DanielHeEGG/RFPhoenix-Hardware/README.md

# RF Phoenix
Open source wireless igniter for amateur rocketry
