DanielHeEGG/RFPhoenix-Hardware/Fabrication/RFPhoenix-Transmitter.FCStd

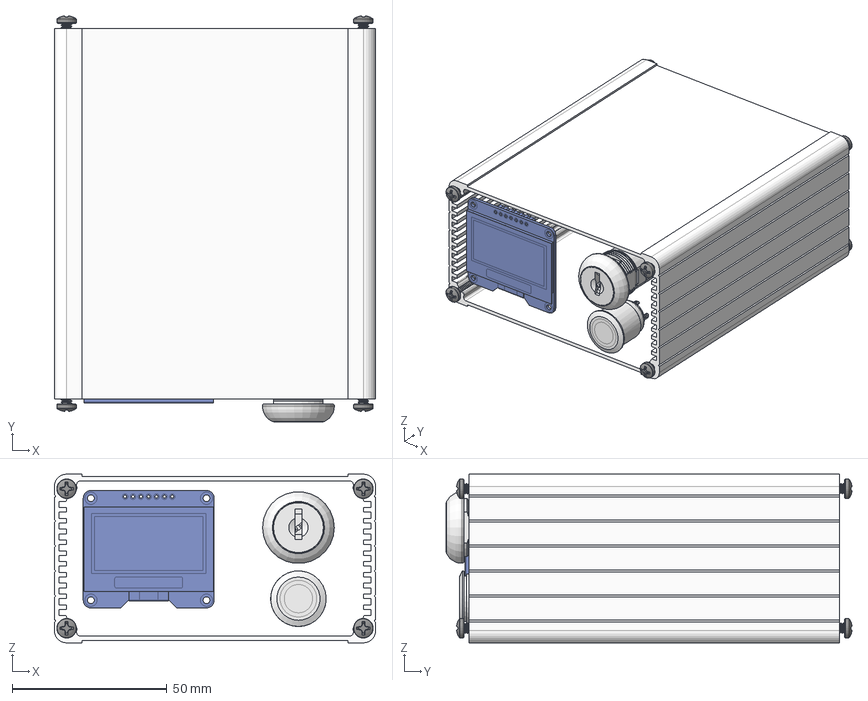
[picture p1: CAD file, 2023-04-13]
Fabrication/RFPhoenix-Transmitter.FCStd
104.0 x 131.4 x 54.6 mm
120mm N Extrusion
6-32 PH x .5 Screw
6-32 PH x .5 Screw001
6-32 PH x .5 Screw002
6-32 PH x .5 Screw003
6-32 PH x .5 Screw004
6-32 PH x .5 Screw005
6-32 PH x .5 Screw006
6-32 PH x .5 Screw007
Orient Display AOM12864A0-2.54
Y201132C203NQ_PART2
Y201132C203NQ_PART1
E-Switch PV6F240SS-341
