DanielHeEGG/RFPhoenix-Hardware/FrontPanel/RFP-Front.kicad_pcb

## KiCad design FrontPanel/RFP-Front.kicad_pcb (2023-05-20)

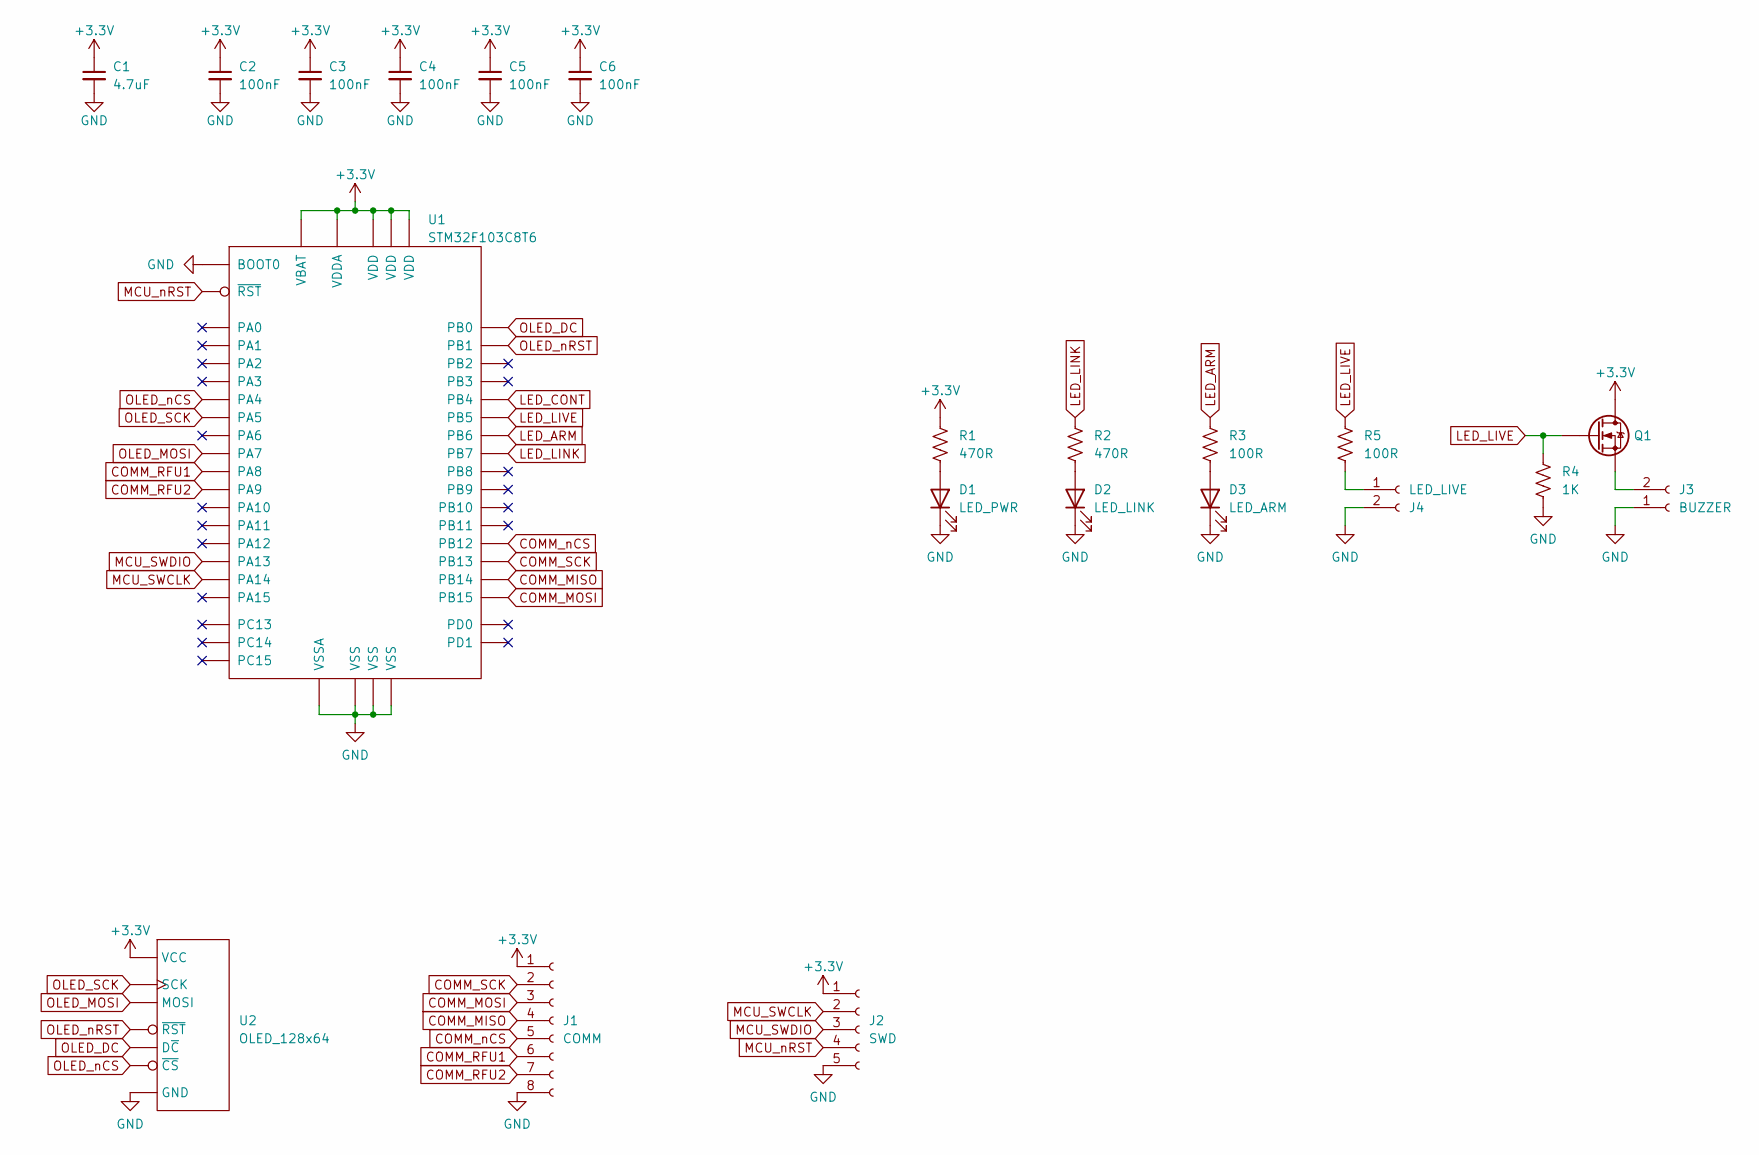
[picture p2: schematic RFP-Front.kicad_sch]

Parts:
C1: 4.7uF; C_0603_1608Metric; Part# Generic 4.7uF 6.3V 0603 X7R MLCC
C2, C3, C4, C5, C6: 100nF; C_0402_1005Metric; Part# Generic 100nF 6.3V 0402 X7R MLCC
D1: LED_PWR; LED_0603_1608Metric; Part# Generic Red 0603 LED
D2: LED_LINK; LED_0603_1608Metric; Part# Generic Green 0603 LED
D3: LED_ARM; LED_0603_1608Metric; Part# Generic Red 0603 LED
J1: COMM; Hirose_DF52-8S-0.8H_1x08-1MP_P0.80mm_Horizontal; Part# DF52-8S-0.8H
J2: SWD; Hirose_DF52-5S-0.8H_1x05-1MP_P0.80mm_Horizontal; Part# DF52-5S-0.8H
J3: BUZZER; Buzzer_Murata_PKMCS0909E
J4: LED_LIVE; R_2512_6332Metric
Q1: SOT-23; Part# Generic SOT-23 N-MOSFET
R1, R2: 470R; R_0402_1005Metric; Part# Generic 470R 0402 Resistor
R3, R5: 100R; R_0402_1005Metric; Part# Generic 100R 0402 Resistor
R4: 1K; R_0402_1005Metric; Part# Generic 1K 0402 Resistor
U1: STM32F103C8T6; LQFP-48_7x7mm_P0.5mm; Part# STM32F103C8T6
U2: OLED_128x64

Connections:
+3.3V: C1.1, C2.1, C3.1, C4.1, C5.1, C6.1, J1.1, J2.1, Q1.3 (D), R1.1, U1.1 (VBAT), U1.9 (VDDA), U1.24 (VDD), U1.36 (VDD), U1.48 (VDD), U2.2 (VCC)
COMM_MISO: J1.4, U1.27 (PB14)
COMM_MOSI: J1.3, U1.28 (PB15)
COMM_RFU1: J1.6, U1.29 (PA8)
COMM_RFU2: J1.7, U1.30 (PA9)
COMM_SCK: J1.2, U1.26 (PB13)
COMM_nCS: J1.5, U1.25 (PB12)
GND: C1.2, C2.2, C3.2, C4.2, C5.2, C6.2, D1.1 (K), D2.1 (K), D3.1 (K), J1.8, J2.5, J3.1, J4.2, R4.2, U1.8 (VSSA), U1.23 (VSS), U1.35 (VSS), U1.44 (BOOT0), U1.47 (VSS), U2.1 (GND)
LED_ARM: R3.1, U1.42 (PB6)
LED_CONT: U1.40 (PB4)
LED_LINK: R2.1, U1.43 (PB7)
LED_LIVE: Q1.1 (G), R4.1, R5.1, U1.41 (PB5)
MCU_SWCLK: J2.2, U1.37 (PA14)
MCU_SWDIO: J2.3, U1.34 (PA13)
MCU_nRST: J2.4, U1.7 (~RST)
unnamed: D1.2 (A), R1.2
unnamed: D2.2 (A), R2.2
unnamed: D3.2 (A), R3.2
unnamed: J3.2, Q1.2 (S)
unnamed: J4.1, R5.2
OLED_DC: U1.18 (PB0), U2.6 (D~C)
OLED_MOSI: U1.17 (PA7), U2.4 (MOSI)
OLED_SCK: U1.15 (PA5), U2.3 (SCK)
OLED_nCS: U1.14 (PA4), U2.7 (~CS)
OLED_nRST: U1.19 (PB1), U2.5 (~RST)

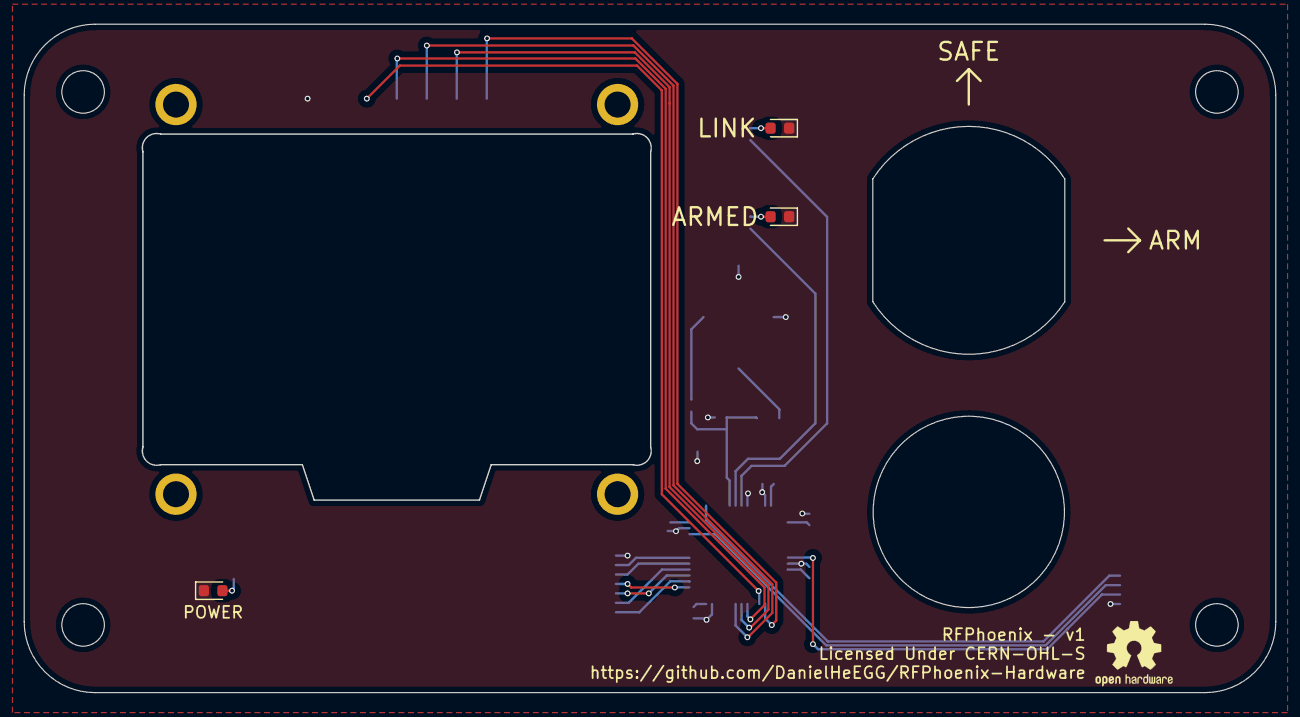
[picture p3: board RFP-Front.kicad_pcb from above]

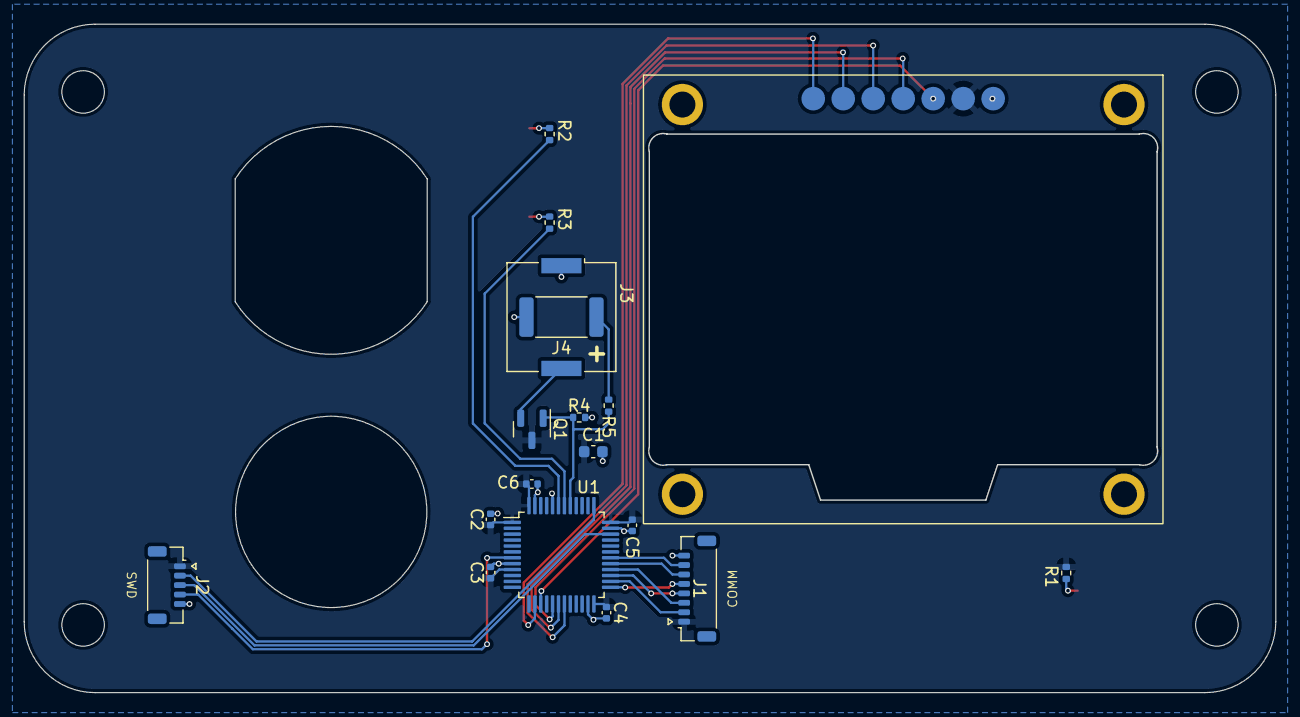
[picture p4: board RFP-Front.kicad_pcb from below]

Board: 2 copper layers, 106.0 x 56.6 mm, 21 parts (17 on the bottom side), 24 nets.
