DanielHeEGG/RFPhoenix-Hardware/Main/RFP-Main.kicad_pcb

## KiCad design Main/RFP-Main.kicad_pcb (2023-04-13)

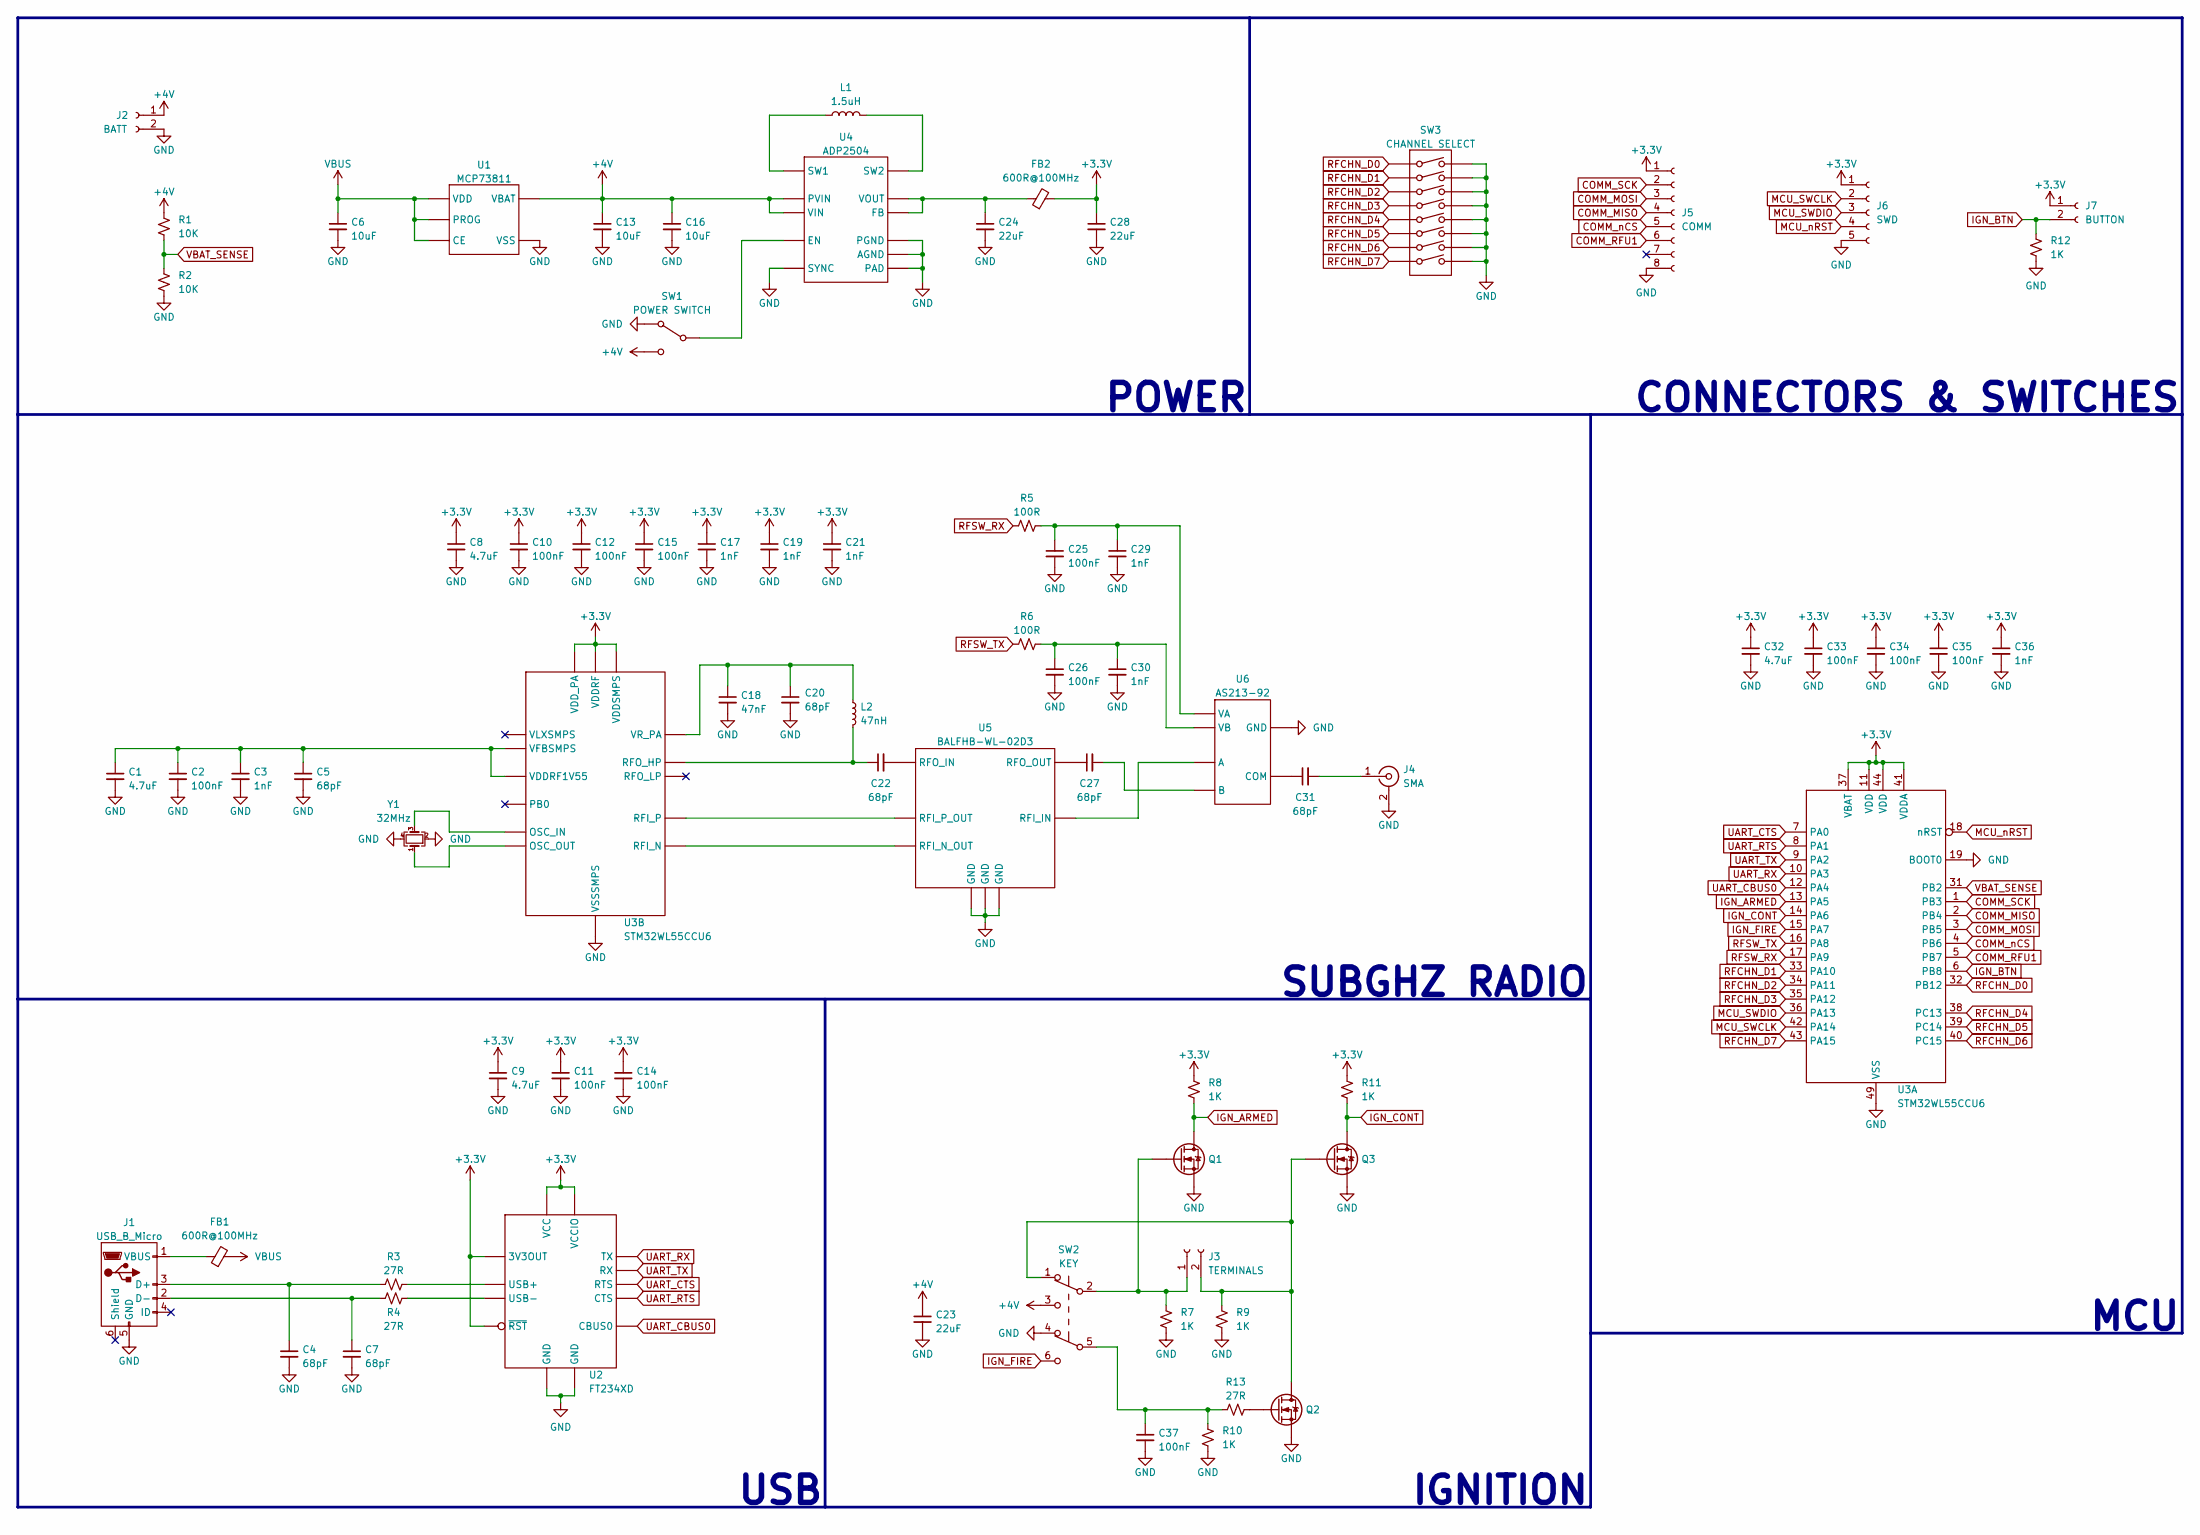
[picture p5: schematic RFP-Main.kicad_sch]

Parts:
C1, C8, C9, C32: 4.7uF; C_0603_1608Metric; Part# Generic 4.7uF 6.3V 0603 X7R MLCC
C2, C10, C11, C12, C14, C15, C25, C26, C33, C34, C35, C37: 100nF; C_0402_1005Metric; Part# Generic 100nF 6.3V 0402 X7R MLCC
C3, C17, C19, C21, C29, C30, C36: 1nF; C_0201_0603Metric; Part# Generic 1nF 6.3V 0201 X7R MLCC
C4, C5, C7, C20, C22, C27, C31: 68pF; C_0201_0603Metric; Part# GRM0335C1H680JA01D
C6, C13, C16: 10uF; C_0805_2012Metric; Part# Generic 10uF 6.3V 0805 X7R MLCC
C18: 47nF; C_0402_1005Metric; Part# Generic 47nF 6.3V 0402 X7R MLCC
C23, C24, C28: 22uF; C_0805_2012Metric; Part# Generic 22uF 6.3V 0805 X7R MLCC
FB1, FB2: 600R@100MHz; R_1206_3216Metric; Part# MH3261-601Y
J1: USB_B_Micro; USB_Micro-B_Molex-105017-0001; Part# 1050170001
J2: BATT; PinSocket_1x02_P2.54mm_Vertical
J3: TERMINALS; PinSocket_1x02_P2.54mm_Vertical
J4: SMA; SMA_Molex_73251-2200_Horizontal; Part# 0732512200
J5: COMM; Hirose_DF52-8S-0.8H_1x08-1MP_P0.80mm_Horizontal; Part# DF52-8S-0.8H
J6: SWD; Hirose_DF52-5S-0.8H_1x05-1MP_P0.80mm_Horizontal; Part# DF52-5S-0.8H
J7: BUTTON; PinSocket_1x02_P2.54mm_Vertical
L1: 1.5uH; L_1008_2520Metric; Part# LQM2HPN1R5MG0L
L2: 47nH; L_0402_1005Metric; Part# LQW15AN47NG00D
Q1, Q2, Q3: SOT-523; Part# DMG1012T
R1, R2: 10K; R_0402_1005Metric; Part# Generic 10K 0.1% 0402 Resistor
R3, R4, R13: 27R; R_0201_0603Metric; Part# Generic 27R 0201 Resistor
R5, R6: 100R; R_0402_1005Metric; Part# Generic 100R 0402 Resistor
R7, R8, R9, R10, R11, R12: 1K; R_0402_1005Metric; Part# Generic 1K 0402 Resistor
SW1: POWER SWITCH; SW_E-Switch_EG1224_SPDT_Angled; Part# EG1224
SW2: KEY; PinSocket_1x06_P2.54mm_Vertical
SW3: CHANNEL SELECT; SW_DIP_SPSTx08_Slide_6.7x21.88mm_W6.73mm_P2.54mm_LowProfile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; Part# 219-8LPSTR
U1: MCP73811; SOT-23-5; Part# MCP73811T-420I/OT
U2: FT234XD; DFN-12-1EP_3x3mm_P0.5mm_EP1.6x2.5mm; Part# FT234XD-R
U3: STM32WL55CCU6; QFN-48-1EP_7x7mm_P0.5mm_EP5.6x5.6mm; Part# STM32WL55CCU6
U4: ADP2504; LFCSP-WD-10-1EP_3x3mm_P0.5mm_EP1.64x2.38mm; Part# ADP2504ACPZ-3.3-R7
U5: BALFHB-WL-02D3; ST_CSPG-8; Part# BALFHB-WL-02D3
U6: AS213-92; SOT-363_SC-70-6; Part# AS213-92LF
Y1: 32MHz; Crystal_SMD_2016-4Pin_2.0x1.6mm; Part# NX2016SA-32M-EXS00A-CS06465

Connections:
+3.3V: C8.1, C9.1, C10.1, C11.1, C12.1, C14.1, C15.1, C17.1, C19.1, C21.1, C28.1, C32.1, C33.1, C34.1, C35.1, C36.1, FB2.2, J5.1, J6.1, J7.1, R8.1, R11.1, U2.2 (~RST), U2.3 (3V3OUT), U2.4 (VCC), U2.9 (VCCIO), U3.11 (VDD), U3.25 (VDD_PA), U3.28 (VDDRF), U3.37 (VBAT), U3.41 (VDDA), U3.44 (VDD), U3.46 (VDDSMPS)
+4V: C13.1, C16.1, C23.1, J2.1, R1.1, SW1.3 (C), SW2.3 (C), U1.3 (VBAT), U4.5 (PVIN), U4.8 (VIN)
COMM_MISO: J5.4, U3.2 (PB4)
COMM_MOSI: J5.3, U3.3 (PB5)
COMM_RFU1: J5.6, U3.5 (PB7)
COMM_SCK: J5.2, U3.1 (PB3)
COMM_nCS: J5.5, U3.4 (PB6)
GND: C1.2, C2.2, C3.2, C4.2, C5.2, C6.2, C7.2, C8.2, C9.2, C10.2, C11.2, C12.2, C13.2, C14.2, C15.2, C16.2, C17.2, C18.2, C19.2, C20.2, C21.2, C23.2, C24.2, C25.2, C26.2, C28.2, C29.2, C30.2, C32.2, C33.2, C34.2, C35.2, C36.2, C37.2, J1.5 (GND), J2.2, J4.2 (Ext), J5.8, J6.5, Q1.2 (S), Q2.2 (S), Q3.2 (S), R2.2, R7.2, R9.2, R10.2, R12.2, SW1.1 (A), SW2.4 (A), SW3.9, SW3.10, SW3.11, SW3.12, SW3.13, SW3.14, SW3.15, SW3.16, U1.2 (VSS), U2.5 (GND), U2.13 (GND), U3.19 (BOOT0), U3.48 (VSSSMPS), U3.49 (VSS), U4.3 (PGND), U4.7 (SYNC), U4.9 (AGND), U4.11 (PAD), U5.B1 (GND), U5.B2 (GND), U5.C2 (GND), U6.2 (GND), Y1.2, Y1.4
IGN_ARMED: Q1.3 (D), R8.2, U3.13 (PA5)
IGN_BTN: J7.2, R12.1, U3.6 (PB8)
IGN_CONT: Q3.3 (D), R11.2, U3.14 (PA6)
IGN_FIRE: SW2.6 (C), U3.15 (PA7)
MCU_SWCLK: J6.2, U3.42 (PA14)
MCU_SWDIO: J6.3, U3.36 (PA13)
MCU_nRST: J6.4, U3.18 (nRST)
unnamed: C1.1, C2.1, C3.1, C5.1, U3.29 (VDDRF1V55), U3.45 (VFBSMPS)
unnamed: C4.1, J1.3 (D+), R3.1
unnamed: C7.1, J1.2 (D-), R4.1
unnamed: C18.1, C20.1, L2.1, U3.24 (VR_PA)
unnamed: C22.1, L2.2, U3.23 (RFO_HP)
unnamed: C22.2, U5.A1 (RFO_IN)
unnamed: C24.1, FB2.1, U4.1 (VOUT), U4.10 (FB)
unnamed: C25.1, C29.1, R5.2, U6.4 (VA)
unnamed: C26.1, C30.1, R6.2, U6.6 (VB)
unnamed: C27.1, U5.C1 (RFO_OUT)
unnamed: C27.2, U6.1 (B)
unnamed: C31.1, U6.5 (COM)
unnamed: C31.2, J4.1 (In)
unnamed: FB1.1, J1.1 (VBUS)
unnamed: J3.1, Q1.1 (G), R7.1, SW2.2 (B)
unnamed: J3.2, Q2.3 (D), Q3.1 (G), R9.1, SW2.1 (A)
unnamed: L1.1, U4.4 (SW1)
unnamed: L1.2, U4.2 (SW2)
unnamed: Q2.1 (G), R13.2
unnamed: R3.2, U2.12 (USB+)
unnamed: R4.2, U2.1 (USB-)
unnamed: C37.1, R10.1, R13.1, SW2.5 (B)
unnamed: SW1.2 (B), U4.6 (EN)
unnamed: U3.20 (RFI_P), U5.A3 (RFI_P_OUT)
unnamed: U3.21 (RFI_N), U5.A2 (RFI_N_OUT)
unnamed: U3.26 (OSC_IN), Y1.3
unnamed: U3.27 (OSC_OUT), Y1.1
unnamed: U5.C3 (RFI_IN), U6.3 (A)
RFCHN_D0: SW3.1, U3.32 (PB12)
RFCHN_D1: SW3.2, U3.33 (PA10)
RFCHN_D2: SW3.3, U3.34 (PA11)
RFCHN_D3: SW3.4, U3.35 (PA12)
RFCHN_D4: SW3.5, U3.38 (PC13)
RFCHN_D5: SW3.6, U3.39 (PC14)
RFCHN_D6: SW3.7, U3.40 (PC15)
RFCHN_D7: SW3.8, U3.43 (PA15)
RFSW_RX: R5.1, U3.17 (PA9)
RFSW_TX: R6.1, U3.16 (PA8)
UART_CBUS0: U2.6 (CBUS0), U3.12 (PA4)
UART_CTS: U2.8 (RTS), U3.7 (PA0)
UART_RTS: U2.11 (CTS), U3.8 (PA1)
UART_RX: U2.7 (TX), U3.10 (PA3)
UART_TX: U2.10 (RX), U3.9 (PA2)
VBAT_SENSE: R1.2, R2.1, U3.31 (PB2)
VBUS: C6.1, FB1.2, U1.1 (CE), U1.4 (VDD), U1.5 (PROG)

Notes on the sheet:
IGNITION
CONNECTORS & SWITCHES
SUBGHZ RADIO
POWER
USB
MCU

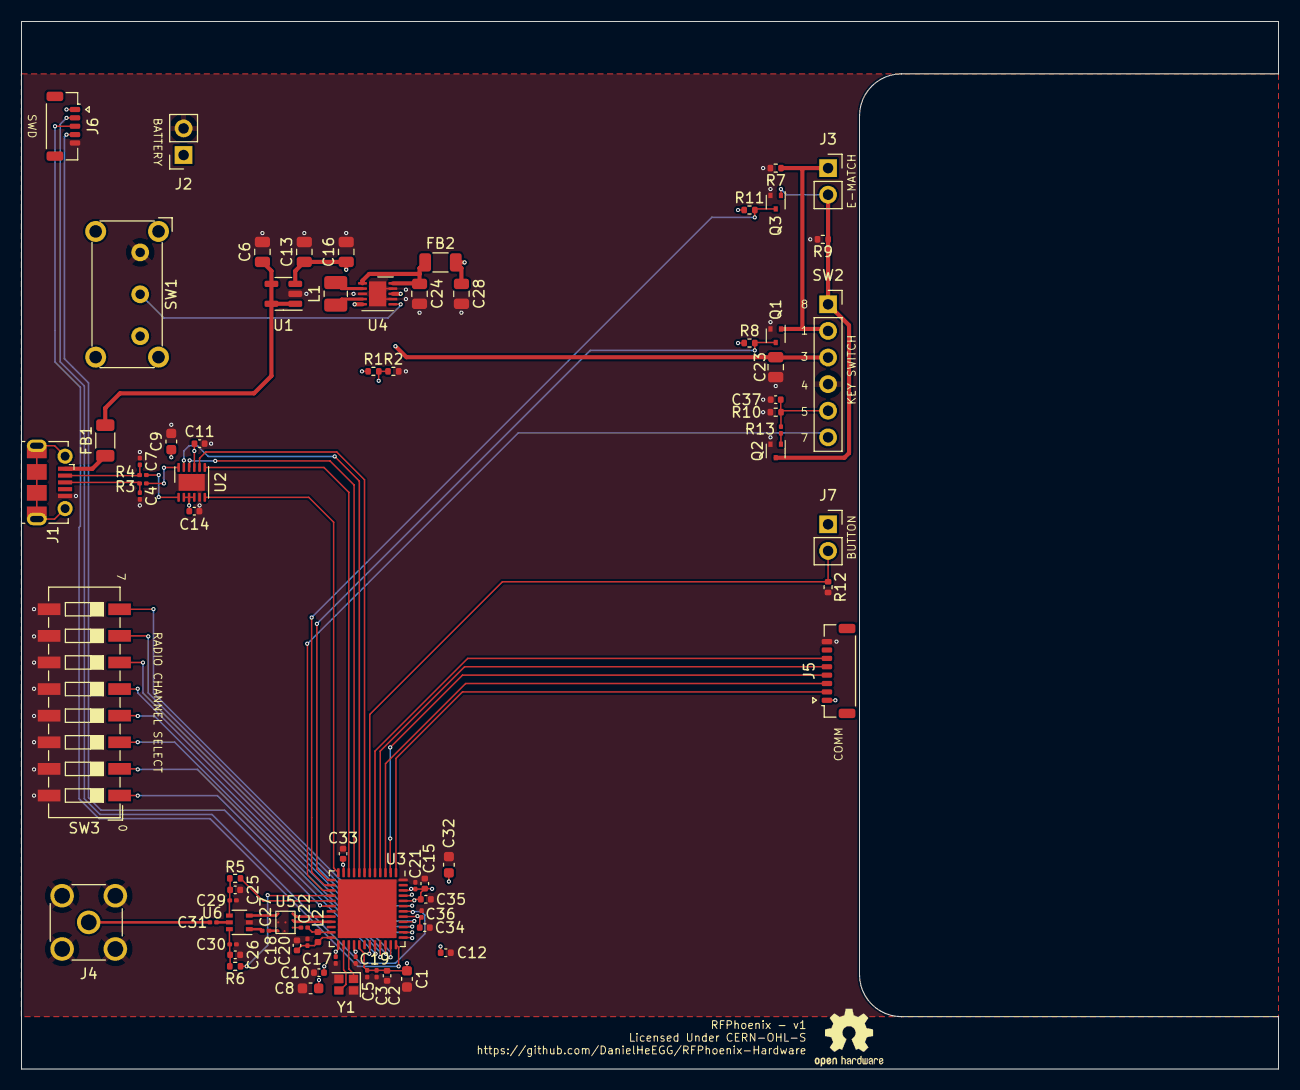
[picture p6: board RFP-Main.kicad_pcb from above]

Board: 4 copper layers, 120.0 x 100.0 mm, 74 parts (0 on the bottom side), 60 nets.
