DanielHeEGG/RFPhoenix-Hardware/(commit log)

2023-04-10 Add front panel design & fabrication files
    [RFP-Front-BOM.csv, RFP-Front.kicad_pcb, RFP-Front.kicad_sch, RFPhoenix-Transmitter.FCStd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]
2023-04-13 Add main board design & fabrication files
    [RFP-Main-BOM.csv, RFP-Main.kicad_pcb, RFP-Main.kicad_sch, RFPhoenix-Transmitter.FCStd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]
2023-04-16 Add rear panel design & fabrication files
    [RFP-Rear.kicad_pcb, RFP-Rear.kicad_sch]
2023-05-20 Rearrange OLED and connector for front panel
    [RFP-Front.kicad_pcb]
2023-05-20 Rearrange and dim LEDs
    [RFP-Front-BOM.csv, RFP-Front.kicad_pcb, RFP-Front.kicad_sch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]
