DanielHeEGG/RFPhoenix-Hardware/(notices)

Notices in the files:
Main/RFP-Main.kicad_pcb:
Licensed Under CERN-OHL-S
